Killvinrie/quad/README.md

## 2026/8/30  00.55

今天开始尝试ota,首先从树莓派和ESP32的通讯开始，现在已经完成了ESP32与树莓派连上路由器的过程，也实现了树莓派启动http_server的过程，已经能通过电脑访问树莓派server,接下来就是用esp32访问树莓派server了，今天先休息；

## 2026/8/30  07.52

考虑实现ESP32的低功耗设计！！！！！！！！！！！！！！！！！！！！！！！！！！！！！！！！！！！！！！！

## 2026/8/31 01.29

将控制器从F407vet6更换为F411CEu6, 只采用mpu6050以及bmp388气压计作为传感器，mp1584作为降压模块给芯片以及传感器供电，原理图已经开始绘制

## 2026/9/3  23.48

基本完善了原理图以及pcb的布局，现在只剩下布线了，以及四个PWM接口的位置，还包括PCB板的固定孔位没有画;

## 2026/9/4 18.56

完成了原理图的绘制并输出gerber文件，已免费打板，等待板子到来，希望一切都好

## 2026/9/5 00.42

完成了cubemx的配置，生成了初始代码。

## 传感器与 OLED 联调

已加入 STM32 传感器采集和 ESP32 OLED 显示程序，接线、构建、烧录及验证步骤见 [software/SENSORS.md](software/SENSORS.md)。

完整程序流程图（含通信协议、寄存器配置、数据换算与异常恢复）见 [software/docs/PROGRAM_FLOW.md](software/docs/PROGRAM_FLOW.md)。

当前手机→ESP32-S3→F411 控制链见 [ESP32 手机遥控说明](software/esp32_oled/README.md)；早期 F103/NRF24 遥控器代码保留在 [controller/](controller/) 归档。

四路同油门电调输出、拆桨测试与行程校准见 [电机说明](software/MOTORS.md)。
