Killvinrie/quad/software/docs/PROGRAM_FLOW.md

# 传感器采集与 OLED 程序完整流程

本文件对应当前拨码切页版本，覆盖 `software/Core` 的 STM32 固件、`software/Common/display_link.h` 共用协议，以及 `software/esp32_oled` 的 ESP32 显示固件。图使用 Mermaid，在支持 Mermaid 的 Markdown 阅读器中可直接显示。寄存器值、公式和分支均按本仓库实现整理。

`test/wifi_test`、`test/hello_world` 是独立实验工程，不参与当前固件运行。当前程序有六轴姿态解算、手机 Wi-Fi 控制链和四路同油门电调输出；X 型姿态 PID/混控代码在完成物理输出映射前默认关闭，没有 OTA 运行链路。

## 1. 整体数据流与接线

```mermaid
flowchart LR
    MPU["MPU6050<br/>三轴加速度 / 三轴角速度 / 温度"] <-->|"I2C1 100kHz<br/>PB6 SCL / PB7 SDA"| STM["STM32F411<br/>采集、校验、换算、选择页面"]
    BMP["BMP388<br/>压力 / 温度 / 出厂校准参数"] <-->|"I2C2 100kHz<br/>PB10 SCL / PB3 SDA"| STM
    GPS["GPS 模块<br/>NMEA GGA"] -->|"9600 8N1<br/>GPS TX → PA10 USART1 RX"| STM
    ADC["电压采样信号"] -->|"PA1 / ADC1 CH1"| STM
    KEY["SW5 四位拨码<br/>SWITCH1 PA6、2 PA7、3 PA8、4 PB9"] --> STM
    STM -->|"USART2 PA2 TX → GPIO18 RX<br/>115200 8N1 / 173字节显示帧"| ESP["ESP32-S3 UART1<br/>帧校验、文字转点阵"]
    ESP -->|"I2C0 100kHz<br/>GPIO5 SCL / GPIO6 SDA"| OLED["SSD1306<br/>128×64 OLED"]
```

| 通信 | 配置 | 当前软件的实际行为 |
| --- | --- | --- |
| MPU6050 | 7 位地址 `0x68` 或 `0x69` | STM32 主动读写寄存器，轮询数据就绪；不使用 MPU_INT 中断采样 |
| BMP388 | 7 位地址 `0x76` 或 `0x77` | STM32 主动读取校准系数、状态和原始数据 |
| GPS USART1 | PA9 TX / PA10 RX，9600 baud，8N1，无流控，16 倍过采样 | 只接收模块主动输出的 GGA，不发送模块配置命令 |
| STM32→ESP32 | PA2 TX→GPIO18 RX，115200 baud，8N1，无流控 | 只发送当前页面文字，无应答、序号或逐帧重传 |
| 手机控制串口 | ESP32 GPIO17 TX→STM32 PA3 RX，115200 baud，8N1 | 接收 QCTRL v1 控制帧并校验 CRC |
| OLED | `0x3C` 或 `0x3D`，100kHz | ESP32 主动写命令及像素；没有读取屏幕内容或芯片 ID |

STM32 的 I²C HAL 接口接收的是左移一位后的地址：`7位地址 << 1`；ESP-IDF 的 OLED 接口使用原始 7 位地址。两者不能直接混用。

## 2. STM32 从复位到主循环

```mermaid
flowchart TD
    A["复位：向量表位于 0x08000000<br/>初始 SP = 0x20020000"] --> B["Reset_Handler → SystemInit<br/>启用 FPU"]
    B --> C["Flash 中的 .data 复制到 RAM<br/>.bss 清零"]
    C --> D["__libc_init_array → main"]
    D --> E["HAL_Init<br/>初始化 HAL / SysTick 毫秒计时"]
    E --> F["SystemClock_Config<br/>25MHz HSE → PLL → 100MHz SYSCLK"]
    F --> G["MX_GPIO_Init<br/>拨码输入 / I2C与UART引脚复用"]
    G --> H["MX_ADC1_Init<br/>PA1 / 12位 / 单次软件触发"]
    H --> I["SensorApp_Init<br/>使能 I2C1、I2C2、USART1、USART2 时钟"]
    I --> J["两路 I2C 初始化为 100kHz<br/>GPS 9600 / 显示链路 115200"]
    J --> K["USART1 中断优先级 5<br/>开启 RXNE 和 ERR 中断"]
    K --> L["等待 100ms<br/>依次 init_imu、init_baro"]
    L --> M["初始化拨码状态<br/>display_page = 0"]
    M --> N["循环调用 SensorApp_Poll"]
    F -. "时钟初始化失败" .-> X["Error_Handler<br/>关闭中断并无限循环"]
    H -. "ADC 初始化失败" .-> X
    J -. "I2C或UART HAL初始化失败" .-> X
```

GCC 启动实现见 [startup_stm32f411xe.S](../GCC/startup_stm32f411xe.S)，时钟与 GPIO 见 [main.c](../Core/Src/main.c)。PLL 参数为 M=12、N=96、P=2，AHB=100MHz、APB1=50MHz、APB2=100MHz。TIM3 使用100MHz计时器时钟，启动四路50Hz电调 PWM。

传感器不存在或不应答不会进入 `Error_Handler`：只标记该传感器不可用，进入主循环继续服务其他设备。上述硬件外设 HAL 初始化失败才是致命错误。

## 3. STM32 主循环与调度

```mermaid
flowchart TD
    A["SensorApp_Poll<br/>now = HAL_GetTick"] --> B["poll_page_switches<br/>读取四位拨码并更新页面"]
    B --> C["poll_gps<br/>消费中断环形缓冲 / 解析完整 GGA"]
    C --> D{"距上次传感器轮询 ≥ 20ms？"}
    D -- 是 --> E["sample_tick = now<br/>先处理 MPU，再处理 BMP"]
    D -- 否 --> F{"距上次重试检查 ≥ 2000ms？"}
    E --> F
    F -- 是 --> G["retry_tick = now<br/>仅对 ready=0 的设备重新初始化"]
    F -- 否 --> H["重新读取 now"]
    G --> H
    H --> I{"距上次显示发送 ≥ 200ms？"}
    I -- 是 --> J["screen_tick = now<br/>ADC 单次采样并换算"]
    J --> K["按 display_page 格式化 8 行文字<br/>封装 CRC 帧 / USART2 阻塞发送"]
    I -- 否 --> L["HAL_Delay 1ms"]
    K --> L
    L --> A
    IRQ["USART1 接收中断<br/>主循环阻塞时仍能接收字节"] -. "写入环形缓冲" .-> C
    TICK["SysTick_Handler<br/>HAL_IncTick"] -. "提供毫秒时间" .-> A
```

| 任务 | 时间设置 | 说明 |
| --- | --- | --- |
| 拨码扫描与 GPS 解析 | 每次主循环 | 没有独立任务线程；编码稳定30ms后生效 |
| MPU/BMP 状态轮询 | 间隔达到 20ms 时执行 | 有数据就读，没有就绪则保留上次值 |
| 传感器重试 | 每 2000ms 检查一次 | 共用重试时间戳，并非每颗设备从报错时刻单独倒计时 |
| ADC / 显示发送 | 间隔达到 200ms 时执行 | 无论当前哪页，都会采 ADC |
| 主循环末尾 | 延时 1ms | 不是整个主循环仅耗时 1ms |

这些间隔是“达到阈值后执行”，不是实时定时器保证的精确周期。I²C 阻塞读写、串口发送、设备初始化延时都会延后下一次循环。拨码切页也要等后续显示发送及 ESP32 绘制，并非 GPIO 变化后立即上屏。

## 4. I²C 寄存器通信的字节过程

`read_reg` / `write_reg` 使用 STM32 HAL 阻塞存储器读写，寄存器地址宽度为 8 位，传入超时参数 20ms。下面是成功交易的总线顺序，HAL 内部等待和错误路径可能另有固定等待，20ms 不代表整个主循环的最坏耗时。

```mermaid
sequenceDiagram
    participant M as STM32 I2C 主机
    participant S as MPU6050 / BMP388 从机
    Note over M,S: 写单个寄存器
    M->>S: START + 7位地址 + W
    S-->>M: ACK
    M->>S: 寄存器地址（1字节）
    S-->>M: ACK
    M->>S: 寄存器值（1字节）
    S-->>M: ACK
    M->>S: STOP
    Note over M,S: 从寄存器连续读 N 字节
    M->>S: START + 7位地址 + W
    S-->>M: ACK
    M->>S: 起始寄存器地址
    S-->>M: ACK
    M->>S: Repeated START + 7位地址 + R
    loop 第1到第N字节
        S-->>M: 数据字节
        Note over M,S: 主机对前N-1字节回ACK，最后一字节回NACK
    end
    M->>S: STOP
```

软件把 `HAL_OK` 视为成功；NACK、总线错误或超时最终表现为失败。当前没有软件 SCL 脉冲解锁总线的逻辑。

## 5. MPU6050：初始化、采样与换算

```mermaid
flowchart TD
    A["init_imu<br/>ready=0 / valid=0"] --> B["依次访问 0x68、0x69<br/>读取 WHO_AM_I 0x75"]
    B --> C{"读成功且值为 0x68？"}
    C -- 否 --> X["结束初始化，保持不可用<br/>等待主循环重试"]
    C -- 是 --> D["写 0x6B = 0x80 复位<br/>成功后等待 100ms"]
    D --> E["依次配置电源、滤波、采样分频、量程"]
    E --> F{"所有写操作成功？"}
    F -- 否 --> X
    F -- 是 --> G["ready=1<br/>记录 imu_tick；等待第一帧数据"]
    G --> H["主循环：读取 INT_STATUS 0x3A"]
    H --> I{"读取成功？"}
    I -- 否 --> Y["ready=0 / valid=0"]
    I -- 是 --> J{"bit0 数据就绪？"}
    J -- 是 --> K["从 0x3B 连读 14 字节"]
    K --> Q{"读取成功？"}
    Q -- 否 --> Y
    Q -- 是 --> L["大端 int16 解码<br/>加速度、温度、角速度换算"]
    L --> C1{"静止水平样本已累计 128 个？"}
    C1 -- 否 --> C2["校准中，valid=0<br/>显示 KEEP LEVEL AND STILL"]
    C1 -- 是 --> C3["扣除静止偏移<br/>AZ 保留 ±1G，再做低通"]
    C3 --> M["valid=1 / imu_tick=当前时间"]
    C2 --> M2["imu_tick=当前时间"]
    J -- 否 --> N{"距 imu_tick 超过 500ms？"}
    M --> N
    M2 --> N
    N -- 是 --> Y
    N -- 否 --> O["结束本次 MPU 处理"]
    Y --> O
```

复位写失败同样直接返回不可用。配置写使用短路 `&&`，某一步失败后不继续后面的配置写。

| 顺序 | 寄存器 | 写入值 | 配置作用 |
| --- | --- | --- | --- |
| 1 | `0x6B PWR_MGMT_1` | `0x01` | 唤醒，选择 PLL 时钟 |
| 2 | `0x6C PWR_MGMT_2` | `0x00` | 启用全部轴 |
| 3 | `0x1A CONFIG` | `0x03` | DLPF：加速度约 44Hz / 陀螺仪约 42Hz |
| 4 | `0x19 SMPLRT_DIV` | `19` | 1kHz / (19+1) = 50Hz |
| 5 | `0x1B GYRO_CONFIG` | `0x00` | ±250°/s，131 LSB/(°/s) |
| 6 | `0x1C ACCEL_CONFIG` | `0x00` | ±2g，16384 LSB/g |

14 字节依次为 AX、AY、AZ、温度、GX、GY、GZ，每项 2 字节，高字节在前。解码与换算严格对应现有整数算法：

```text
u = (高字节 << 8) | 低字节
raw = u >= 32768 ? u - 65536 : u

acc[i]   = trunc(raw_acc[i] × 1000 / 16384)    // 单位 0.001 g
 gyro[i] = trunc(raw_gyro[i] × 100 / 131)      // 单位 0.01 °/s
imu_temp = trunc(raw_temp × 100 / 340) + 3653 // 单位 0.01 °C
```

这里 `trunc` 表示 C 整数除法向零截断。上电后用 128 个水平、稳定的有效样本建立静止零偏：AX/AY 与 GX/GY/GZ 扣除各自均值；AZ 扣除 `(均值 - ±1000mg)`，因此水平静止时仍显示约 ±1G。若样本波动过大或水平条件不满足，重新收集；之后偏移保持固定，再对显示读数进行 1/4 新样本的一阶低通。屏幕分别显示 3、2、2 位小数。陀螺仪静止偏移大于 20°/s 时，标题提示 `MPU BIAS HIGH`。姿态解算直接使用校准后的原速率样本，避免显示低通带来额外相位滞后。

姿态页的链路为：校准后的六轴数据 → 根据传感器 -X 指向机头、启动时 Z 轴重力符号变换到机体 X 前/Y 左/Z 上 → 根据实际采样时间间隔积分角速度四元数并归一化 → 当加速度合量在 0.8–1.2G 时，用重力方向误差修正横滚/俯仰 → 转成欧拉角，格式化为度。大加速度时跳过重力修正，避免把平移加速度误认成倾斜。启动时用重力确定横滚/俯仰并把航向设为相对零点；没有磁力计，因此航向可能随陀螺仪零偏漂移。输出符号为左侧抬起 ROLL 正、机头抬起 PITCH 正、向右转 YAW 正。采样间隔超过 100ms 时重新初始化姿态，避免长时间缺样后错误积分。

## 6. BMP388：初始化及读取流程

```mermaid
flowchart TD
    A["init_baro<br/>ready=0 / valid=0"] --> B["探测 0x76、0x77<br/>读取 0x00，期望 CHIP_ID=0x50"]
    B --> C["读 STATUS 0x03<br/>要求 bit4 命令就绪"]
    C --> D["写 CMD 0x7E=0xB6 复位<br/>等待 10ms"]
    D --> E["从 0x31 连读 21 字节校准系数<br/>拒绝全0或全FF"]
    E --> F["解码温度及压力补偿系数"]
    F --> G["配置过采样、ODR、IIR、正常模式<br/>等待 5ms"]
    G --> H["读 ERR_REG 0x02<br/>读取失败或低3位非零则 ready=0"]
    H --> I["记录 baro_tick / 返回主循环"]
    I --> J["ready=1 时，轮询 STATUS 0x03"]
    J --> K{"读取成功且 bit5、bit6 都就绪？"}
    K -- 两者就绪 --> L["从 0x04 连读 6 字节<br/>压力3字节 + 温度3字节"]
    L --> M["小端 uint24 解码<br/>先温度，再压力补偿"]
    M --> N{"读取、计算、范围检查都成功？"}
    N -- 是 --> O["valid=1<br/>更新压力、温度、baro_tick"]
    N -- 否 --> X["ready=0 / valid=0"]
    K -- 读取失败 --> X
    K -- 未全就绪 --> P{"距 baro_tick 超过500ms？"}
    O --> P
    P -- 是 --> X
    P -- 否 --> Q["结束本次 BMP 处理"]
    X --> Q
```

初始化中任何必要读写失败都不会发布有效数据；下一次 2 秒重试检查会重新执行初始化。校准字节校验只排除了全 0 / 全 FF，额外的结果合理性由补偿后的范围检查承担。

| 寄存器 | 值 | 当前配置 |
| --- | --- | --- |
| `0x1C OSR` | `0x03` | 压力 ×8，温度 ×1 |
| `0x1D ODR` | `0x03` | 25Hz |
| `0x1F CONFIG` | `0x04` | IIR 系数 3 |
| `0x1B PWR_CTRL` | `0x33` | 压力、温度使能，normal 模式 |

原始数据布局：`0x04..0x06` 为压力低/中/高字节，`0x07..0x09` 为温度低/中/高字节。

```text
raw_p = b0 | (b1 << 8) | (b2 << 16)
raw_t = b3 | (b4 << 8) | (b5 << 16)
```

## 7. BMP388：21 字节系数和完整补偿公式

源代码：[bmp388_math.c](../Core/Src/bmp388_math.c)。以下 `u16` 为小端无符号数，`s16` 为小端补码有符号数，`s8` 为有符号字节；偏移从读出的 21 字节数组起算。表中数组下标与代码一致，从 0 开始。

| 系数 | 字节偏移 | 原始类型 | 转换公式 |
| --- | --- | --- | --- |
| t[0] | 0–1 | u16 | raw × 2^8 |
| t[1] | 2–3 | u16 | raw / 2^30 |
| t[2] | 4 | s8 | raw / 2^48 |
| p[0] | 5–6 | s16 | (raw − 2^14) / 2^20 |
| p[1] | 7–8 | s16 | (raw − 2^14) / 2^29 |
| p[2] | 9 | s8 | raw / 2^32 |
| p[3] | 10 | s8 | raw / 2^37 |
| p[4] | 11–12 | u16 | raw × 2^3 |
| p[5] | 13–14 | u16 | raw / 2^6 |
| p[6] | 15 | s8 | raw / 2^8 |
| p[7] | 16 | s8 | raw / 2^15 |
| p[8] | 17–18 | s16 | raw / 2^48 |
| p[9] | 19 | s8 | raw / 2^48 |
| p[10] | 20 | s8 | raw / 2^65 |

```mermaid
flowchart LR
    A["21字节校准参数"] --> B["解码符号 / 缩放<br/>double t、p 数组"]
    R["raw_t"] --> C["d = raw_t - t0"]
    B --> C
    C --> D["T = d*t1 + d*d*t2"]
    P["raw_p"] --> E["压力三次多项式<br/>同时使用温度 T"]
    B --> E
    D --> E
    E --> F["有限数检查<br/>T在-40至85°C<br/>P在30000至125000Pa"]
    F --> G["温度转百分之一°C整数<br/>压力转Pa整数"]
    G --> H["P/100 显示 hPa<br/>温度 /100 显示°C<br/>相对高度 H 显示 m"]
```

```text
d = raw_t − t[0]
T = d × t[1] + d² × t[2]
r = raw_p

P = p[4] + T × (p[5] + T × (p[6] + T × p[7]))
  + r × (p[0] + T × (p[1] + T × (p[2] + T × p[3])))
  + r² × (p[8] + T × p[9] + r × p[10])

若 T/P 不是有限数，或 T < -40，T > 85，P < 30000，P > 125000：失败。
温度整数 = trunc(T × 100 + (T < 0 ? -0.5 : 0.5))
压力整数 = trunc(P + 0.5)
```

所有补偿中间值使用 `double`。显示气压时以 100 为小数缩放系数，把 Pa 显示为 hPa，保留两位小数。压力先使用 1/8 新样本的一阶低通；上电后累计 32 个有效滤波压力样本求平均作为基准 `P0`，期间高度保持 0m。之后使用 `H=44330×(1-(P/P0)^0.190294957)` 计算相对高度，再使用 1/4 新样本的一阶低通，显示米并保留两位小数。滤波只抑制噪声，不对高度做死区或自动归零处理；基准只在本次上电周期内有效。MPU 和 ADC 也分别使用 1/4 新样本的一阶低通。

## 8. GPS：中断接收与主循环解析

```mermaid
flowchart TD
    A["USART1_IRQHandler<br/>SensorApp_GpsIRQ"] --> B["读取 SR 状态<br/>有 RXNE 或接收错误时再读 DR"]
    B --> C{"ORE / FE / NE / PE？"}
    C -- 是 --> D["gps_overflow=1<br/>丢弃当前字节，返回中断"]
    C -- 否 --> E{"下一写位置等于读位置？"}
    E -- 是 --> D
    E -- 否 --> F["写入 gps_ring<br/>推进 gps_head，返回中断"]
    F -. "主循环消费" .-> G["poll_gps"]
    D -. "主循环恢复" .-> G
    G --> H{"gps_overflow=1？"}
    H -- 是 --> I["短暂关中断，清空环形缓冲<br/>清错误标记，再开中断<br/>清半句缓存和 gps_seen"]
    H -- 否 --> J["逐字节消费，推进 gps_tail"]
    I --> J
    J --> K{"当前字节？"}
    K -- 美元符号 --> L["重新开始一条 NMEA 句子"]
    K -- 换行且正在收句 --> M["补字符串结束符<br/>调用 Gps_ParseGga"]
    K -- 其他且正在收句 --> N["追加字符<br/>超过缓存则丢弃半句"]
    K -- 未开始收句 --> O["忽略字节"]
    M --> P{"返回成功？"}
    P -- 是 --> Q["更新 gps 数据<br/>gps_tick=当前时间 / gps_seen=1"]
    P -- 否 --> R["不更新旧 gps 和时间戳"]
    L --> J
    N --> J
    O --> J
    Q --> J
    R --> J
```

环形缓冲分配 1024 字节，使用“留一个空槽区分满/空”的方法，实际最大积压为 1023 字节。句子缓存 128 字节，最多存 127 个字符再加终止符。图中“逐字节消费”在缓冲为空时返回主循环，不会空转等待。中断只收字节，不进行字符串解析。

### GGA 校验和字段处理

```mermaid
flowchart TD
    A["完整句子进入 Gps_ParseGga"] --> B["要求以美元符号开头<br/>存在星号及两位十六进制校验值"]
    B --> C["只允许校验后为空或 CR / LF / CRLF"]
    C --> D["对美元符号之后、星号之前的字节逐个异或<br/>与收到的校验值比较"]
    D --> E["按逗号原地切分，保留空字段<br/>字段数10至16，类型名5字符且后3位GGA"]
    E --> F["质量字段必须单字符0至8<br/>卫星字段最多2位数字，空字段按0处理"]
    F --> G{"quality 非零？"}
    G -- 否 --> H["生成无定位状态<br/>经纬度及方向保持清零"]
    G -- 是 --> I["纬度4位整数部分，经度5位整数部分<br/>检查数字、小数点位置、分钟及度数范围"]
    I --> J["纬度方向 N/S、经度方向 E/W<br/>坐标字符串复制到临时 next"]
    H --> K["整体验证通过才用 next 覆盖 gps"]
    J --> K
    B -. "任一检查失败" .-> X["返回0，不覆盖现有定位"]
    C -.-> X
    D -.-> X
    E -.-> X
    F -.-> X
    I -.-> X
    J -.-> X
```

典型帧：

```text
$GPGGA,123519,4807.038,N,01131.000,E,1,08,0.9,545.4,M,46.9,M,,*47\r\n
          UTC    纬度  北纬   经度  东经 质量 卫星
```

字段按类型名为第 0 项计数：2=纬度、3=N/S、4=经度、5=E/W、6=质量、7=卫星数。UTC、HDOP、高度等没有保存或参与显示。代码接受任意两字符 talker 前缀，不仅 GP/GN；它不是完整 NMEA 语义验证器。

纬度范围到 90°，经度到 180°，分钟必须小于 60，达到最大度数时分钟必须为 0。坐标字符串长度小于 16。显示保留 `DDMM.MMMM` / `DDDMM.MMMM`，**没有转十进制度**。例如 `4807.038 N` 是北纬 48 度 7.038 分。

quality=0 的合法 GGA 也刷新接收时间，显示 `WAITING FOR FIX`。从未收到合法 GGA，或距最近合法 GGA 超过 3000ms，显示 `NO GGA / TIMEOUT`。非零质量均按当前实现显示坐标，没有进一步区分自主定位、差分、估算等质量含义。

## 9. ADC 与拨码页面选择

```mermaid
flowchart TD
    A["每200ms显示周期"] --> B["adc_valid=0<br/>HAL_ADC_Start"]
    B --> C{"启动成功且5ms内转换完成？"}
    C -- 是 --> D["读取12位 adc_raw<br/>0至4095"]
    D --> E["adc_mv = 整数除法<br/>(adc_raw × 3300 + 2047) / 4095"]
    E --> F["adc_valid=1"]
    C -- 否 --> G["保留无效状态<br/>显示 ADC ERROR"]
    F --> H["HAL_ADC_Stop<br/>进入页面格式化"]
    G --> H
```

ADC1：PA1/channel 1，12 位右对齐，非连续、非扫描，软件触发，采样时间 144 cycles，ADC 时钟为 APB2/4=25MHz。公式中的 3300mV 是配置假设，没有动态测量 VREF。显示 PA1 电压及原码，不乘电池分压系数。没有多次平均或软件滤波。

```mermaid
flowchart TD
    A["每次主循环扫描SW5四位拨码"] --> B["读取GPIO<br/>低电平=开关接通"]
    B --> C{"编码和上次 raw 不同？"}
    C -- 是 --> D["更新 raw 和 changed_at"]
    C -- 否 --> E{"stable与raw不同<br/>且保持至少30ms？"}
    D --> E
    E -- 否 --> Z["本键无事件"]
    E -- 是 --> F["stable_code = raw_code"]
    F --> G{"编码是0、1、2、3、4？"}
    G -- 否 --> Z["保持当前页面"]
    G -- 是 --> H["page=编码：MPU/BMP/GPS/姿态/电机PWM"]
```

SWITCH1=PA6、SWITCH2=PA7、SWITCH3=PA8、SWITCH4=PB9，软件启用内部上拉，开关接通为低电平。四位编码为 `code = SW1 + 2×SW2 + 4×SW3 + 8×SW4`。`0000`、`0001`、`0010`、`0011`、`0100` 分别选择 MPU、BMP/ADC、GPS、姿态、电机 PWM；其他编码保持上一页。拨码编码连续稳定30ms后生效，不存在长按连翻逻辑。

页面顺序：0=MPU6050，1=BMP388/ADC，2=GPS，3=姿态，4=电机 PWM。页面变化不影响所有传感器的持续轮询和 GPS 接收。

## 10. 显示数据组织与串口帧

```mermaid
flowchart LR
    A["当前数值及有效标志"] --> B["send_screen<br/>选择 display_page"]
    B --> C["有效：格式化数值和单位<br/>无效：写离线或超时文字"]
    C --> D["8行，每行最多21字符<br/>STM32内存中每行22字节含终止符"]
    D --> E["display_encode<br/>不足21字符补空格，超长截断"]
    E --> F["写 QD 帧头和版本1<br/>计算 CRC16，低字节先发"]
    F --> G["HAL_UART_Transmit<br/>173字节，超时参数30ms"]
    G --> H["无逐帧重传<br/>后续200ms周期发最新完整页"]
```

| 页面 | 行号（从0开始） | 内容 |
| --- | --- | --- |
| MPU | 0 | `1/5 MPU6050` |
| MPU | 1–3 | AX、AY、AZ，单位 G，3位小数 |
| MPU | 4–6 | GX、GY、GZ，单位 D/S，2位小数 |
| MPU | 7 | 温度，单位 C，2位小数 |
| BMP/ADC | 0 | `2/5 BMP388 / ADC` |
| BMP/ADC | 2、3 | 压力 HPA、温度 C |
| BMP/ADC | 4、5、6、7 | 相对高度 H、ADC RAW、还原后的原电压 BAT、`DIV:10/43 ADC` |
| GPS | 0、1 | 页标题、FIX质量与SAT卫星数 |
| GPS | 2–5 | 经纬度格式标题、原始度分字符串和方向 |
| 姿态 | 0、2–4 | `4/5 ATTITUDE`、ROLL/PITCH/YAW，单位 DEG，2位小数 |
| 姿态 | 6–7 | 安装方向提示、航向为相对值提示 |
| 电机 PWM | 0–5 | `5/5 MOTOR PWM (US)`、实际解锁/PID 状态、FR/FL/RR/RL 的 CH1～CH4 脉宽 |
| 电机 PWM | 7 | 拆桨测试提示 |

每次先清零全部行数组，因此缺省行变成空白，错误页不会残留本次未写入的旧行。`fixed()` 用整数绝对值、商、余数及符号格式化，不需要浮点 printf。

### 固定 173 字节协议

| 字节偏移 | 字节数 | 含义 |
| --- | --- | --- |
| 0 | 1 | ASCII `Q`，0x51 |
| 1 | 1 | ASCII `D`，0x44 |
| 2 | 1 | 版本，0x01 |
| 3–170 | 168 | 8行×21列 ASCII，按行排列，无换行和字符串终止符 |
| 171 | 1 | CRC低字节 |
| 172 | 1 | CRC高字节 |

第 r 行第 c 列的位置是 `3 + r×21 + c`。CRC16-CCITT-FALSE：初值 `0xFFFF`、多项式 `0x1021`、无输入/输出反射、无末尾异或；覆盖字节 0–170。每输入一字节，先异或到 CRC 高8位，再左移8次，移出最高位为1时异或多项式。

8N1 每字节含1起始位、8数据位、1停止位；173字节在115200 baud下的纯线路时间约为 `173×10/115200 = 15.02ms`。不含调用开销和异常等待。协议只带显示文字，没有原始数值结构、测量时间戳或采样序号。

## 11. ESP32 接收、校验和断流处理

```mermaid
flowchart TD
    A["app_main"] --> B["建立 I2C0 总线<br/>GPIO6 SDA / GPIO5 SCL<br/>内部上拉开启 / glitch_ignore_cnt=7"]
    B --> C["安装 UART1 驱动<br/>RX环形缓存4096字节，TX缓存0<br/>RX18 / TX17 / 115200 8N1"]
    C --> D["screen写入等待STM32文字<br/>start_oled首次探测和初始化"]
    D --> E["循环：uart_read_bytes<br/>一次最多256字节，等待参数20ms"]
    E --> F["逐字节调用 display_feed"]
    F --> G{"收到CRC正确的完整帧？"}
    G -- 是 --> H["复制全部8行，每行补终止符<br/>last_rx=当前tick<br/>received=1 / stale=0 / dirty=1"]
    G -- 否 --> I["不更新screen及last_rx"]
    H --> J{"曾收到合法帧且未标超时<br/>距last_rx超过2000ms？"}
    I --> J
    J -- 是 --> K["清screen，写 STM32 LINK LOST<br/>stale=1 / dirty=1"]
    J -- 否 --> L{"OLED离线且距重试达到2000ms？"}
    K --> L
    L -- 是 --> M["start_oled再次探测<br/>dirty=1，失败记录日志"]
    L -- 否 --> N{"online且dirty<br/>距上次绘制达到200ms？"}
    M --> N
    N -- 是 --> O["draw_screen：逐页写SSD1306"]
    O --> P{"写入成功？"}
    P -- 是 --> Q["dirty=0"]
    P -- 否 --> R["online=0，记录重试时间和日志"]
    Q --> E
    R --> E
    N -- 否 --> E
```

I²C 总线创建、UART 驱动安装/参数/引脚配置调用 `ESP_ERROR_CHECK`，失败会进入 ESP-IDF 致命错误处理，不走 OLED 的普通重试分支。显示任务是 `app_main` 内的循环，UART 底层接收由 ESP-IDF 驱动缓存，没有另外创建显示工作任务。

从未收到合法帧时一直显示 `WAIT STM32 DATA`；只有曾经收到后再断流，才显示 `STM32 LINK LOST`。CRC 错帧不会延长在线时间。同一次读取中若有多帧，后面的合法帧会覆盖前面的 screen，最终绘制最新一帧。

### 接收帧重新同步

```mermaid
flowchart TD
    A["追加一个串口字节到 parser.bytes"] --> B{"当前缓存开头符合已收到的<br/>Q / D / 版本1？"}
    B -- 否 --> C["丢掉第一个字节<br/>其余左移，used减1"]
    C --> B
    B -- 是或缓存为空 --> D{"已收满173字节？"}
    D -- 否 --> E["返回0，等待后续字节"]
    D -- 是 --> F["计算前171字节CRC<br/>比较末尾小端CRC"]
    F --> G{"相同？"}
    G -- 否 --> H["仅丢掉最前一个字节<br/>used减1，返回0"]
    H --> E
    G -- 是 --> I["复制168字节文字到screen<br/>每行补0，used清零，返回1"]
```

CRC 失败不是清空全部缓存，而是滑动一个字节；下次输入继续寻找帧头，能恢复截断、插入噪声和错位。解析器没有单独的半帧接收超时。CRC提供错误检测，不提供加密或身份认证。

## 12. OLED 初始化与逐页点阵写入

```mermaid
flowchart TD
    A["start_oled"] --> B["若旧device存在，先从总线移除"]
    B --> C["先探测0x3C，后0x3D<br/>每次probe超时参数25ms"]
    C --> D{"地址应答？"}
    D -- 否 --> E["试下一个地址<br/>都失败则online=0"]
    D -- 是 --> F["添加设备：7位地址 / 100kHz"]
    F --> G["发送初始化命令串<br/>超时参数50ms"]
    G --> H{"成功？"}
    H -- 是 --> I["online=1 / 记录地址日志"]
    H -- 否 --> J["移除设备，试下一个地址"]
    I --> K["draw_screen：row=0至7"]
    K --> L["发命令：00、B0+row、00、10<br/>选择页并把列地址置0"]
    L --> M["把21字符转换为5列字模<br/>每字符后留1列空白"]
    M --> N["发送129字节<br/>40控制字节 + 128列像素"]
    N --> O{"本页及此前传输均成功？"}
    O -- 否 --> P["立即返回错误<br/>主循环标记OLED离线"]
    O -- 是 --> Q{"8页完成？"}
    Q -- 否 --> K
    Q -- 是 --> R["返回ESP_OK"]
```

设备添加失败时直接返回离线；初始化命令发送失败时移除该设备并继续尝试后续地址。页定位命令失败也立即返回，不发送该页像素。

### 初始化发送的所有命令

最前面的 `0x00` 是 I²C 命令控制字节，不是 SSD1306 寄存器地址。后续顺序如下：

| 命令及参数 | 作用 |
| --- | --- |
| `AE` | 关闭显示 |
| `D5 80` | 显示时钟设置 |
| `A8 3F` | 64行复用 |
| `D3 00` | 显示偏移0 |
| `40` | 起始显示行0 |
| `8D 14` | 启用内部电荷泵 |
| `20 02` | 页寻址模式 |
| `A1` | 段地址映射方向 |
| `C8` | COM扫描方向 |
| `DA 12` | COM引脚布局 |
| `81 7F` | 对比度 |
| `D9 F1` | 预充电设置 |
| `DB 40` | VCOMH设置 |
| `A4` | 根据显存显示 |
| `A6` | 正常显示，不反色 |
| `2E` | 禁用滚动 |
| `AF` | 开启显示 |

### 文字变成像素的过程

```text
128×64 像素 → 8个页，每页8像素高、128列宽
每字符：5列字模 + 1列间隔 → 21字符占126列，最后2列空白
一个字模列用1字节表示，bit0在上、bit7在下
pixels[0] = 0x40                     // 数据控制字节
pixels[1 + 字符序号×6 + 字模列号] = glyph(字符, 字模列号)
其余pixels字节保持0                   // 字间距、行末空白
```

字体覆盖 `0–9`、`A–Z`、`- . : / +`，其他字符显示为空白，不支持中文。单页先发4字节命令，再发129字节数据；一屏共16次 I²C 写交易、1064字节控制/命令/像素负载，像素数据本身为1024字节。

加上每次交易的地址字节及 ACK，100kHz下纯位传输时间约 `(1064+16)×9/100000 = 97.2ms`，未计 START/STOP、驱动调度与异常等待。屏幕按页依次改写，没有双缓冲或垂直同步，逻辑上的整帧接收不等于屏幕硬件一次性刷新。当前没有差分刷新，dirty是“有新帧/新状态待画”，不是“字符内容确实不同”。

## 13. 手机 Wi-Fi 控制链与 F411 接收

```mermaid
flowchart LR
    A["手机浏览器<br/>双虚拟摇杆"] --> B["ESP32 SoftAP<br/>QUAD-CONTROL / 192.168.4.1"]
    B --> C["HTTP POST /api/control<br/>约50ms一次，严格校验0..4095"]
    C --> D["control_encode<br/>QCTRL v1 / CRC16"]
    D --> F["UART1<br/>ESP GPIO17 TX → F411 PA3 RX"]
    F --> G["USART2 RX 中断<br/>SensorApp_LinkIRQ"]
    G --> H["ControlApp_RxByte<br/>滑动同步 + CRC 校验"]
    H --> I["ControlApp_GetLatest<br/>最新轴量/250 ms 超时"]
    I --> J["MotorLogic<br/>解锁校验/逐路测试"]
    J -->|"配置映射后启用"| P["Stabilizer<br/>X 型角度P+角速度PID"]
    P --> K["TIM3 CH1-4<br/>50Hz / PB4 PB5 PB0 PB1"]
    J -->|"默认同油门/逐路测试"| K
```

QCTRL v1 固定 20 字节：`51 43 01` 帧头、序号、YAW/THR/PITCH/ROLL 四个小端 16 位值、按键位、flags、电池电压字段、保留字节和 CRC16-CCITT。手机网页传四轴原码、OLED 页面、解锁请求及物理通道测试请求；ESP32 将解锁放入 flags bit0，逐路测试放入 bit1、buttons 存 1～4，并填写序号与 CRC。HTTP 任务收到合法请求后立即经 UART 发给 F411。F411 主循环校验解锁与测试条件；默认映射 1100–1940μs 同油门，单路测试时只有选中通道输出 1250μs。X 型角度 P/角速度 PID 和四电机混控已实现，但在确认 PWM 线映射前默认关闭。TIM3 中断输出四路 50Hz；链路失效或主循环停滞超过 250ms 时回最低油门。详见[电机说明](../MOTORS.md)。

## 14. 异常与恢复汇总

| 异常 | 立即动作 | 恢复路径 |
| --- | --- | --- |
| STM32 时钟、ADC、I²C/UART HAL初始化失败 | 关中断，停在 Error_Handler | 需要排查并复位 |
| MPU/BMP不存在、ID错误、配置失败 | ready=0，valid=0 | 主循环每2秒重试初始化 |
| MPU/BMP采样交易失败 | ready=0，valid=0，不显示旧测量值 | 同上 |
| MPU/BMP超过500ms无新数据 | 清ready/valid | 同上 |
| BMP补偿非有限数或超范围 | 清ready/valid | 同上 |
| GPS UART硬件错误或环形缓冲满 | 置gps_overflow | 主循环丢弃积压和半句，等待新的完整GGA |
| GPS校验/字段错误 | 不更新定位与时间戳 | 后续合法GGA覆盖；超3秒显示超时 |
| GPS合法GGA但quality=0 | 更新为无定位状态 | 有效定位GGA到来后显示坐标 |
| ADC启动或转换失败 | adc_valid=0 | 下一个200ms周期重采 |
| STM32显示串口发送失败 | 不检查返回值，不立即重传 | 下周期发最新完整帧，ESP接收器重新同步 |
| 显示帧错位或CRC错误 | 不改screen、不更新last_rx | 滑动查找下一合法帧 |
| ESP收到数据后断流超过2秒 | 清旧屏幕文字，显示链路断开 | 新合法帧自动恢复 |
| 手机 HTTP 指令超过250ms未更新 | 手机 OLED 页显示链路断开，ESP不产生新控制帧 | 网页恢复发送后更新；F411 自行按250ms超时判断 |
| OLED无应答或写失败 | online=0 | 每2秒探测并完整初始化 |

错误检测的时间点受主循环阻塞影响，上表时间都是程序判断阈值，而非严格的最长故障响应时间。

## 15. 图与代码的对应关系

| 内容 | 源文件与主要函数 |
| --- | --- |
| 复位、段初始化、向量表 | [GCC/startup_stm32f411xe.S](../GCC/startup_stm32f411xe.S) |
| 内存布局 | [GCC/stm32f411xe.ld](../GCC/stm32f411xe.ld)：512KiB Flash / 128KiB RAM，4KiB栈、2KiB堆 |
| 主函数、GPIO、ADC、时钟 | [Core/Src/main.c](../Core/Src/main.c) |
| 调度、传感器寄存器、拨码、页面 | [Core/Src/sensor_app.c](../Core/Src/sensor_app.c)：SensorApp_Init / SensorApp_Poll / send_screen |
| BMP系数及公式 | [Core/Src/bmp388_math.c](../Core/Src/bmp388_math.c) |
| GPS句子校验 | [Core/Src/gps_nmea.c](../Core/Src/gps_nmea.c)：Gps_ParseGga |
| GPS与SysTick中断入口 | [Core/Src/stm32f4xx_it.c](../Core/Src/stm32f4xx_it.c) |
| 两端共用显示协议 | [Common/display_link.h](../Common/display_link.h)：display_encode / display_feed / display_crc |
| 手机控制协议 | [Common/control_link.h](../Common/control_link.h)：control_encode / control_feed / control_decode |
| F411 控制帧接收 | [Core/Src/control_app.c](../Core/Src/control_app.c)：ControlApp_RxByte / ControlApp_GetLatest |
| ESP32接收和OLED | [esp32_oled/main/oled_main.c](../esp32_oled/main/oled_main.c)：app_main / start_oled / draw_screen / glyph |
| ESP32热点/网页 | [esp32_oled/main/phone_server.c](../esp32_oled/main/phone_server.c)、[esp32_oled/main/phone_control.html](../esp32_oled/main/phone_control.html) |
| STM32配置常量 | [Core/Inc/sensor_config.h](../Core/Inc/sensor_config.h) |
| ESP32默认参数 | [esp32_oled/main/Kconfig.projbuild](../esp32_oled/main/Kconfig.projbuild)，实际构建以sdkconfig为准 |

以上描述的是当前代码行为，不代表所有分支已完成硬件验证。后续若修改寄存器、调度或帧版本，应同步更新本文件。
