Killvinrie/quad/harware/iceda/ProPrj_quadcopter_2026-08-31/IMAGE/db6c82e433164412970b5fee896ddc21.webp

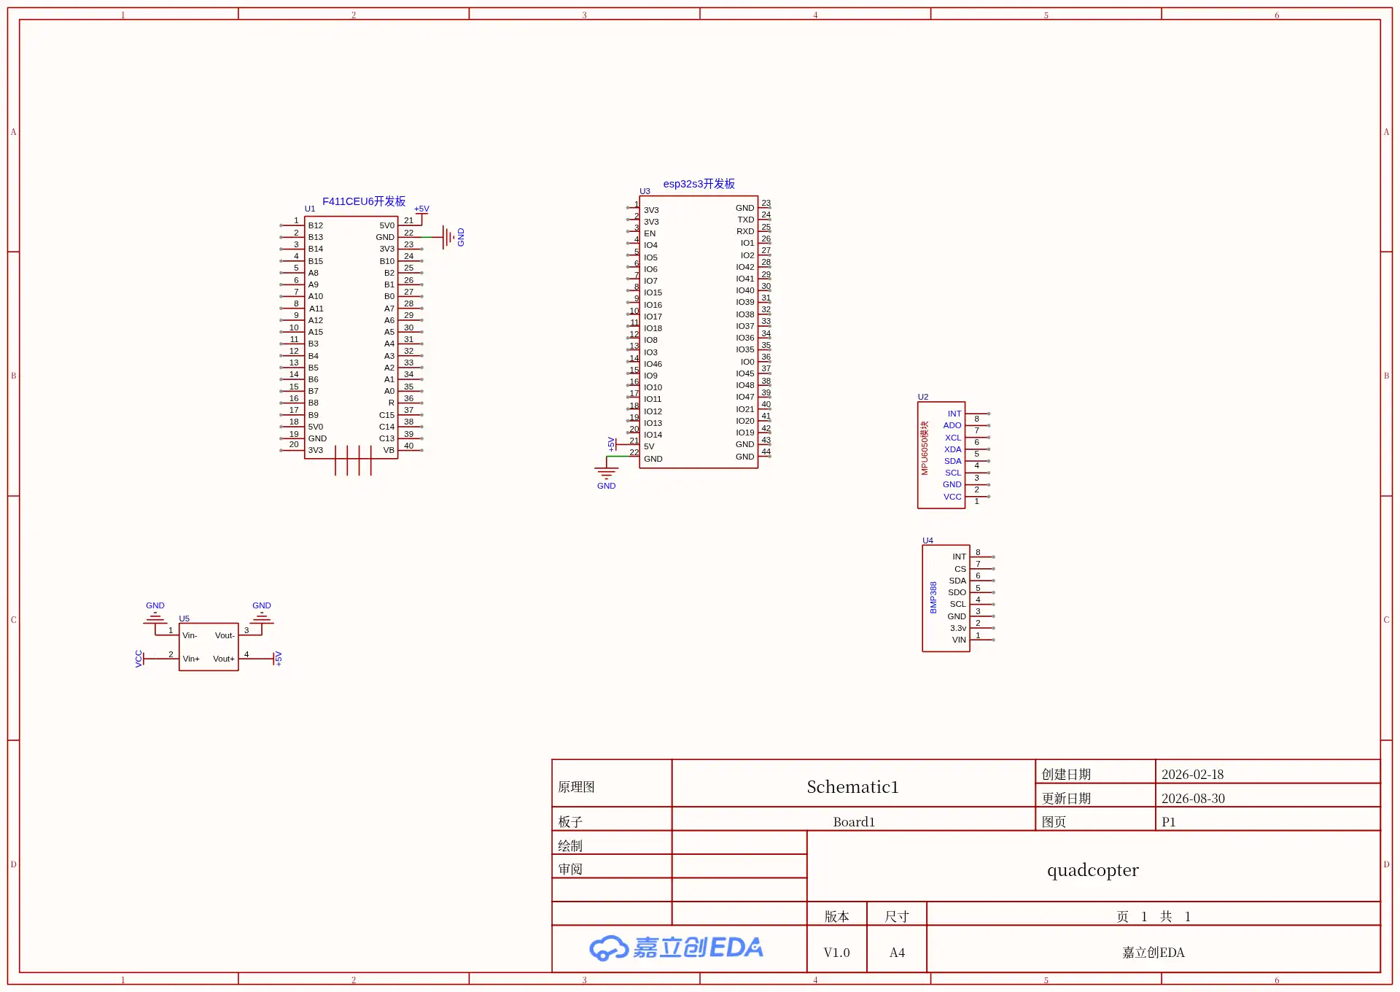
harware/iceda/ProPrj_quadcopter_2026-08-31/IMAGE/db6c82e433164412970b5fee896ddc21.webp
