Killvinrie/quad/harware/iceda/ProPrj_quadcopter_2026-09-03/IMAGE/b7ed33bf6a544b78bbe6192cf4f77103.webp

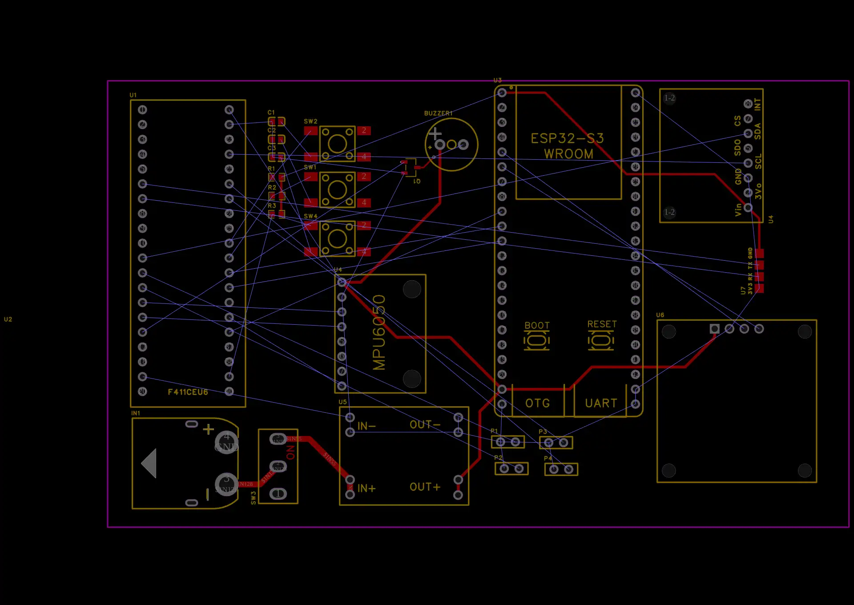
harware/iceda/ProPrj_quadcopter_2026-09-03/IMAGE/b7ed33bf6a544b78bbe6192cf4f77103.webp
