Killvinrie/quad/harware/iceda/ProPrj_quadcopter_2026-09-03/IMAGE/db6c82e433164412970b5fee896ddc21.webp

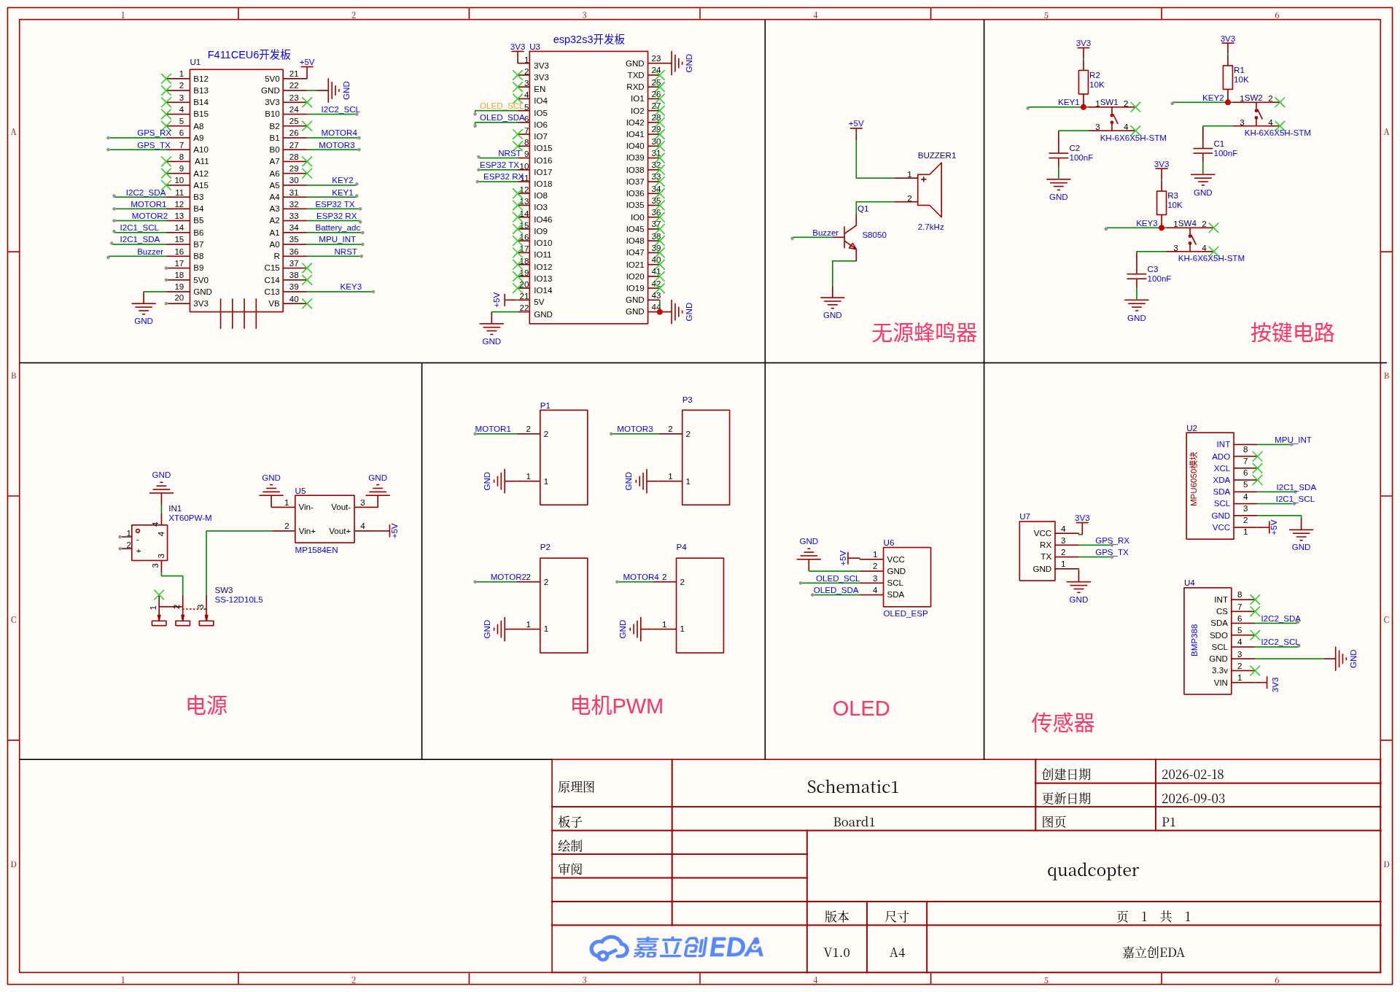
harware/iceda/ProPrj_quadcopter_2026-09-03/IMAGE/db6c82e433164412970b5fee896ddc21.webp
