Killvinrie/quad/software/Core/Inc/main.h

#define MPU_INT_Pin GPIO_PIN_0
#define MPU_INT_GPIO_Port GPIOA
#define Bateery_ADC_Pin GPIO_PIN_1
#define Bateery_ADC_GPIO_Port GPIOA
#define ESP32_TX_Pin GPIO_PIN_2
#define ESP32_TX_GPIO_Port GPIOA
#define ESP32_RX_Pin GPIO_PIN_3
#define ESP32_RX_GPIO_Port GPIOA
#define SWITCH1_Pin GPIO_PIN_6
#define SWITCH1_GPIO_Port GPIOA
#define SWITCH2_Pin GPIO_PIN_7
#define SWITCH2_GPIO_Port GPIOA
#define SWITCH3_Pin GPIO_PIN_8
#define SWITCH3_GPIO_Port GPIOA
#define GPS_TX_Pin GPIO_PIN_9
#define GPS_TX_GPIO_Port GPIOA
#define GPS_RX_Pin GPIO_PIN_10
#define GPS_RX_GPIO_Port GPIOA
#define SWITCH4_Pin GPIO_PIN_9
#define SWITCH4_GPIO_Port GPIOB
