Killvinrie/quad/software/Core/Src/motor_app.c

#include "main.h"
#include "control_app.h"
#include "motor_app.h"
#include "motor_logic.h"
#include "motor_config.h"
#include "sensor_app.h"
#include "stabilizer.h"

/* TIM3 is clocked at 100 MHz (APB1 timer x2). Prescaler 99 gives a 1 MHz
 * counter. CH1..CH4 are PB4, PB5, PB0, PB1 on this board. */
static MotorLogic logic;
static Stabilizer stabilizer;
static volatile uint16_t requested_us[4] = {
    MOTOR_MIN_US, MOTOR_MIN_US, MOTOR_MIN_US, MOTOR_MIN_US
};
static volatile uint32_t last_poll_ms;
static volatile uint8_t poll_stalled;
static uint32_t last_attitude_tick;
static uint8_t stabilizing;

void MotorApp_Init(void)
{
    MotorLogic_Init(&logic);
    Stabilizer_Reset(&stabilizer);
    stabilizing = 0;
    for (unsigned i = 0; i < 4; ++i) requested_us[i] = MOTOR_MIN_US;
    last_poll_ms = HAL_GetTick();
    __HAL_RCC_TIM3_CLK_ENABLE();
    TIM3->CR1 = 0;
    TIM3->CCER = 0;
    TIM3->PSC = 99U;
    TIM3->ARR = 19999U;
    TIM3->CCR1 = MOTOR_MIN_US;
    TIM3->CCR2 = MOTOR_MIN_US;
    TIM3->CCR3 = MOTOR_MIN_US;
    TIM3->CCR4 = MOTOR_MIN_US;
    TIM3->CCMR1 = (6U << 4) | TIM_CCMR1_OC1PE |
                  (6U << 12) | TIM_CCMR1_OC2PE;
    TIM3->CCMR2 = (6U << 4) | TIM_CCMR2_OC3PE |
                  (6U << 12) | TIM_CCMR2_OC4PE;
    TIM3->CR1 = TIM_CR1_ARPE;
    TIM3->EGR = TIM_EGR_UG;
    TIM3->SR = 0;
    TIM3->DIER = TIM_DIER_UIE;
    TIM3->CCER = TIM_CCER_CC1E | TIM_CCER_CC2E |
                 TIM_CCER_CC3E | TIM_CCER_CC4E;
    HAL_NVIC_SetPriority(TIM3_IRQn, 6, 0);
    HAL_NVIC_EnableIRQ(TIM3_IRQn);
    TIM3->CR1 |= TIM_CR1_CEN;
}

void MotorApp_Poll(void)
{
    ControlCommand command;
    uint32_t now = HAL_GetTick();
    int valid = ControlApp_GetLatest(&command, now);
    if (poll_stalled) {
        MotorLogic_ForceDisarm(&logic);
        poll_stalled = 0;
    }
    uint16_t base = MotorLogic_Update(&logic, &command, valid);
    uint16_t pulse[4] = {base, base, base, base};
    if (!logic.armed) {
        stabilizing = 0;
        Stabilizer_Reset(&stabilizer);
        last_attitude_tick = 0;
        unsigned test_channel = MotorLogic_TestChannel(&logic, &command, valid);
        if (test_channel) pulse[test_channel - 1U] = MOTOR_TEST_US;
    }
#if MOTOR_STABILIZATION_ENABLED
    else {
        SensorAttitude sample;
        if (!SensorApp_GetAttitude(&sample, now)) {
            stabilizing = 0;
            MotorLogic_ForceDisarm(&logic);
            Stabilizer_Reset(&stabilizer);
            last_attitude_tick = 0;
            for (unsigned i = 0; i < 4; ++i) pulse[i] = MOTOR_MIN_US;
        } else if (command.axis[1] == 0U) {
            stabilizing = 0;
            Stabilizer_Reset(&stabilizer);
            last_attitude_tick = 0;
            for (unsigned i = 0; i < 4; ++i) pulse[i] = MOTOR_MIN_US;
        } else if (sample.tick_ms != last_attitude_tick) {
            uint16_t logical[4];
            float dt = last_attitude_tick ?
                (float)(sample.tick_ms - last_attitude_tick) * 0.001f : 0.02f;
            if (!Stabilizer_Step(&stabilizer, &command, &sample, dt, logical)) {
                stabilizing = 0;
                MotorLogic_ForceDisarm(&logic);
                for (unsigned i = 0; i < 4; ++i) pulse[i] = MOTOR_MIN_US;
            } else {
                stabilizing = 1;
                pulse[MOTOR_OUTPUT_FL] = logical[0];
                pulse[MOTOR_OUTPUT_FR] = logical[1];
                pulse[MOTOR_OUTPUT_RR] = logical[2];
                pulse[MOTOR_OUTPUT_RL] = logical[3];
            }
            last_attitude_tick = sample.tick_ms;
        } else {
            for (unsigned i = 0; i < 4; ++i) pulse[i] = requested_us[i];
        }
    }
#endif
    __disable_irq();
    for (unsigned i = 0; i < 4; ++i) requested_us[i] = pulse[i];
    last_poll_ms = now;
    __enable_irq();
    IWDG->KR = 0xAAAAU;
}

void MotorApp_GetStatus(MotorAppStatus *out)
{
    if (!out) return;
    /* TIM3 is configured for a 1 MHz counter, so CCR ticks equal us.
     * Read the timer values that are scheduled for the PWM outputs. */
    out->pwm_us[0] = (uint16_t)TIM3->CCR1;
    out->pwm_us[1] = (uint16_t)TIM3->CCR2;
    out->pwm_us[2] = (uint16_t)TIM3->CCR3;
    out->pwm_us[3] = (uint16_t)TIM3->CCR4;
    out->armed = logic.armed &&
        (uint32_t)(HAL_GetTick() - last_poll_ms) <= CONTROL_LINK_TIMEOUT_MS;
    out->stabilizing = out->armed && stabilizing;
}

void MotorApp_StartWatchdog(void)
{
    /* LSI is nominally 32 kHz: /64 and reload 999 gives about 2 seconds.
     * Start only after sensor initialization, then feed from the main loop. */
    IWDG->KR = 0xCCCCU;
    IWDG->KR = 0x5555U;
    IWDG->PR = 4U;
    IWDG->RLR = 999U;
    while (IWDG->SR != 0U) {}
    IWDG->KR = 0xAAAAU;
}

void TIM3_IRQHandler(void)
{
    if (TIM3->SR & TIM_SR_UIF) {
        TIM3->SR = 0;
        uint16_t pulse[4];
        for (unsigned i = 0; i < 4; ++i) pulse[i] = requested_us[i];
        if ((uint32_t)(HAL_GetTick() - last_poll_ms) >
            CONTROL_LINK_TIMEOUT_MS) {
            for (unsigned i = 0; i < 4; ++i) pulse[i] = MOTOR_MIN_US;
            poll_stalled = 1;
        }
        TIM3->CCR1 = pulse[0];
        TIM3->CCR2 = pulse[1];
        TIM3->CCR3 = pulse[2];
        TIM3->CCR4 = pulse[3];
    }
}
