Killvinrie/quad/controller/stm32f103/Core/Src/runtime.c

#include <stddef.h>

/* Freestanding build: provide the one C runtime routine emitted by GCC. */
void *memset(void *destination, int value, size_t count)
{
    unsigned char *p = destination;
    while (count--) *p++ = (unsigned char)value;
    return destination;
}
