Killvinrie/quad/(commit log)

2026-08-30 create hardware/ in main directory , Start to draw PCB, GREAT IMPROVEMENT!
2026-08-30 Revise README with new project updates
    Updated README with additional notes on ESP32 low power design and hardware changes.
2026-09-02 update the schematic with 4 keys and one buZZer to enhance debug features
2026-09-03 optimize the README and almost finish the schematic of QUAD
2026-09-04 Finish the V1.0 script of FC_BOARD and create the ./hardware/gerber folder to track the board version
2026-09-15 fix some compatible issue on board and generate new gerber file
2026-09-22 codex generate :sensors can stably run and the communication between esp32 and f411 is good , but the feature of switch screen with key did't work very well , fixing.....
    [bmp388_math.c, bmp388_math.h, check.py, check_firmware.py, gps_nmea.c, gps_nmea.h]
2026-09-22 fix page switch feature , the Button Debounce Circuit was like a shit !!!-----------Codex generate the initial controller code and add some controller code for f411 and esp32 but esp32 need to be con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
    [check.py, control_app.c, control_app.h, controller_app.c, main.h]
2026-09-24 1.complete the controller code 2. add calibration feature for mpu6050, 3.add attitude algorithm and display on screen
2026-09-24 abort controller and use mobilephone instead to sen control instruction to esp32
2026-09-24 motorl control test done ,now we can use mobilephone to ajust throttle
2026-09-27 add stablize code and adjusting pid parameters
